yokosumei/Keryke-OS/kerike_concurs/docs/schema de conectare raspberry pi.drawio.png

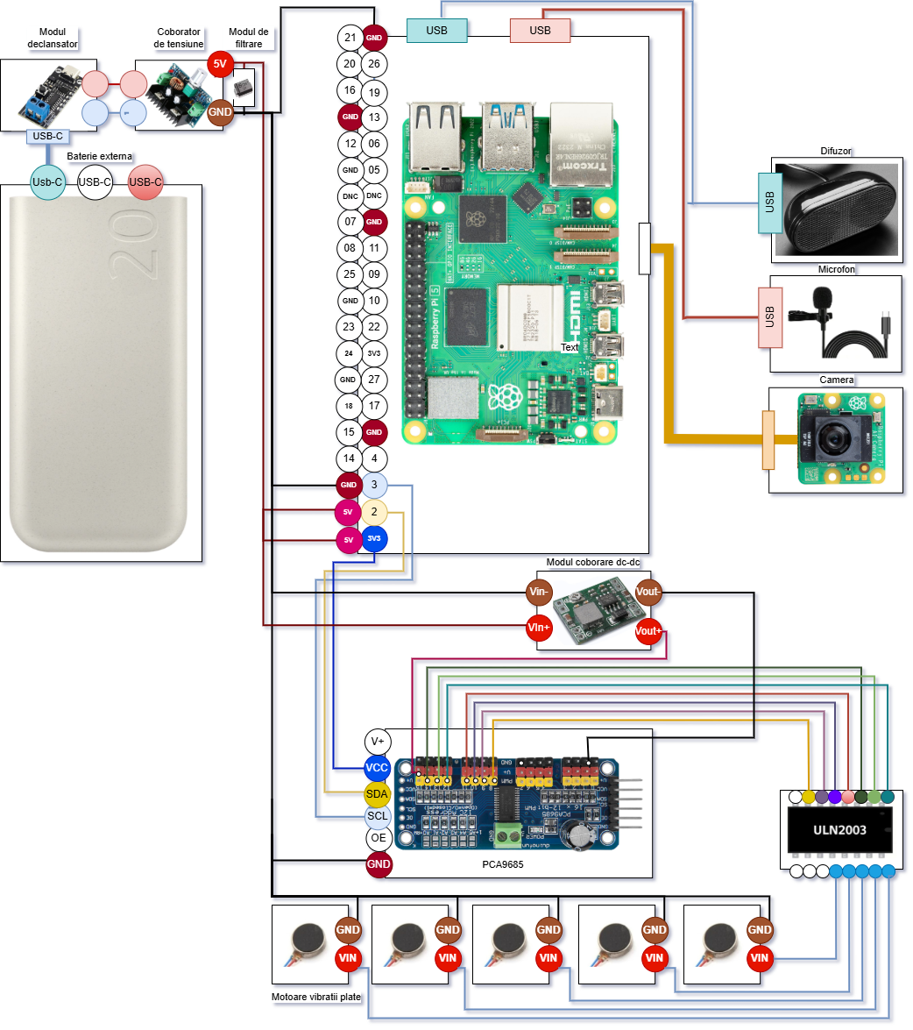
kerike_concurs/docs/schema de conectare raspberry pi.drawio.png
