yokosumei/Keryke-OS/kerike_concurs/docs/fig4_heartbeat.png

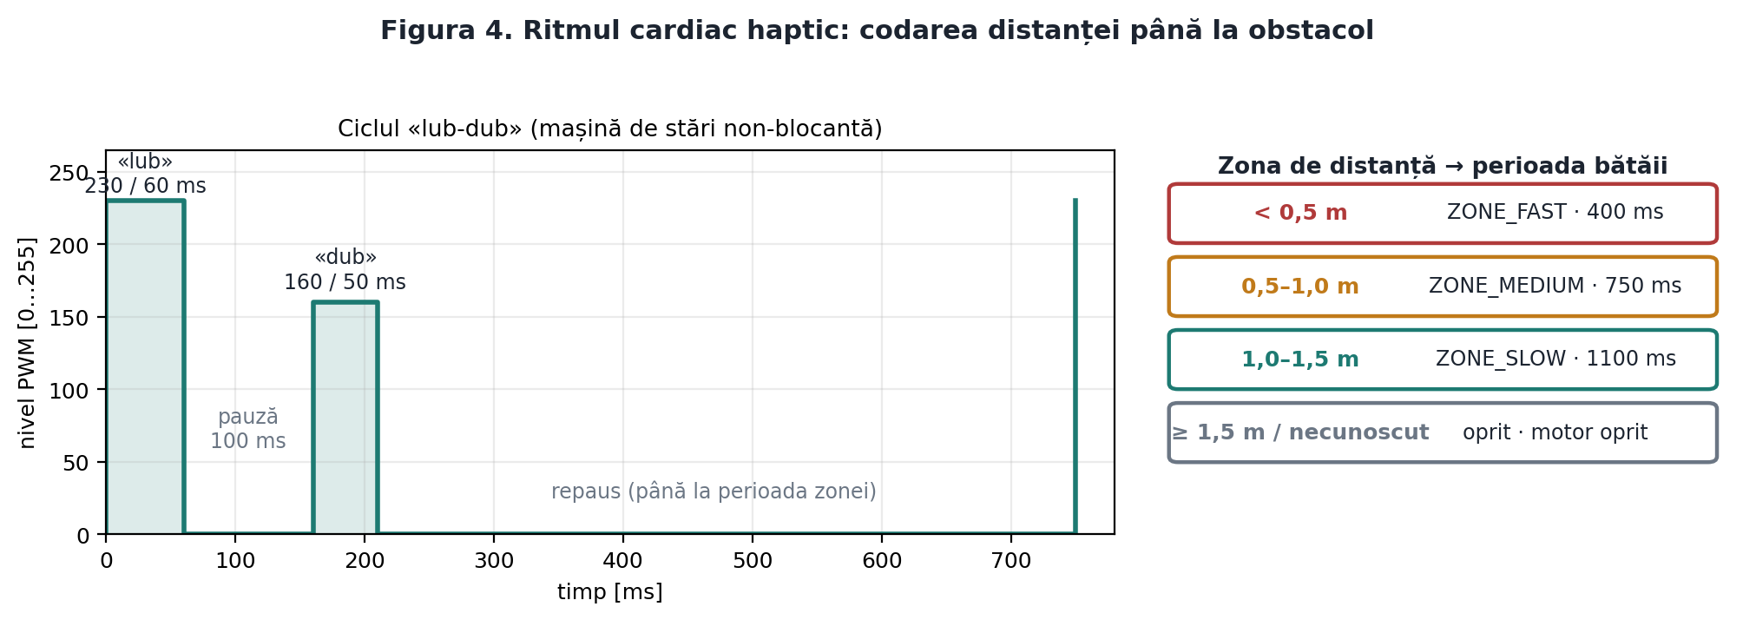
kerike_concurs/docs/fig4_heartbeat.png
