yokosumei/Keryke-OS/kerike_concurs/docs/fig5_schema_orcad_baston.png

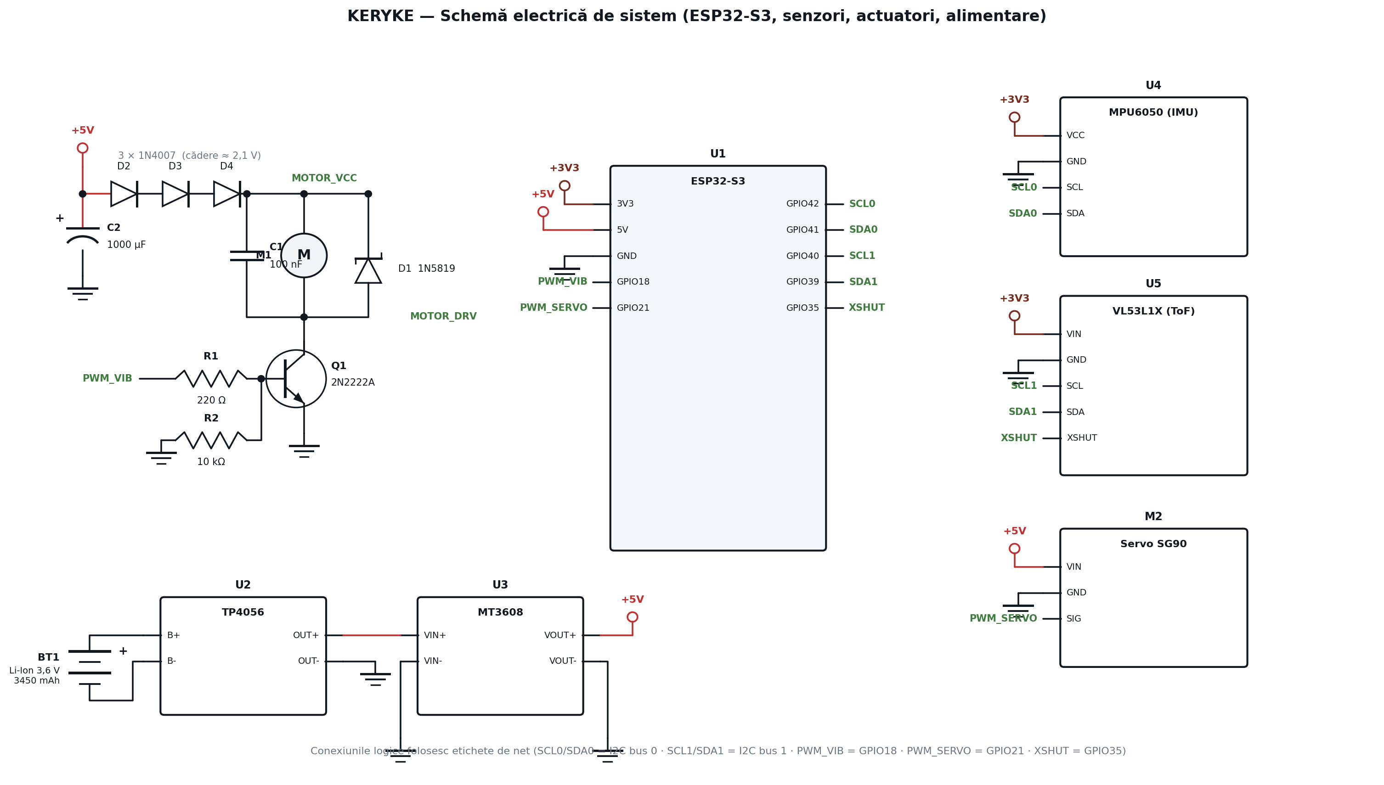
kerike_concurs/docs/fig5_schema_orcad_baston.png
