yokosumei/Keryke-OS/kerike_concurs/docs/fig9_schema_Orcad_raspberryPi.png

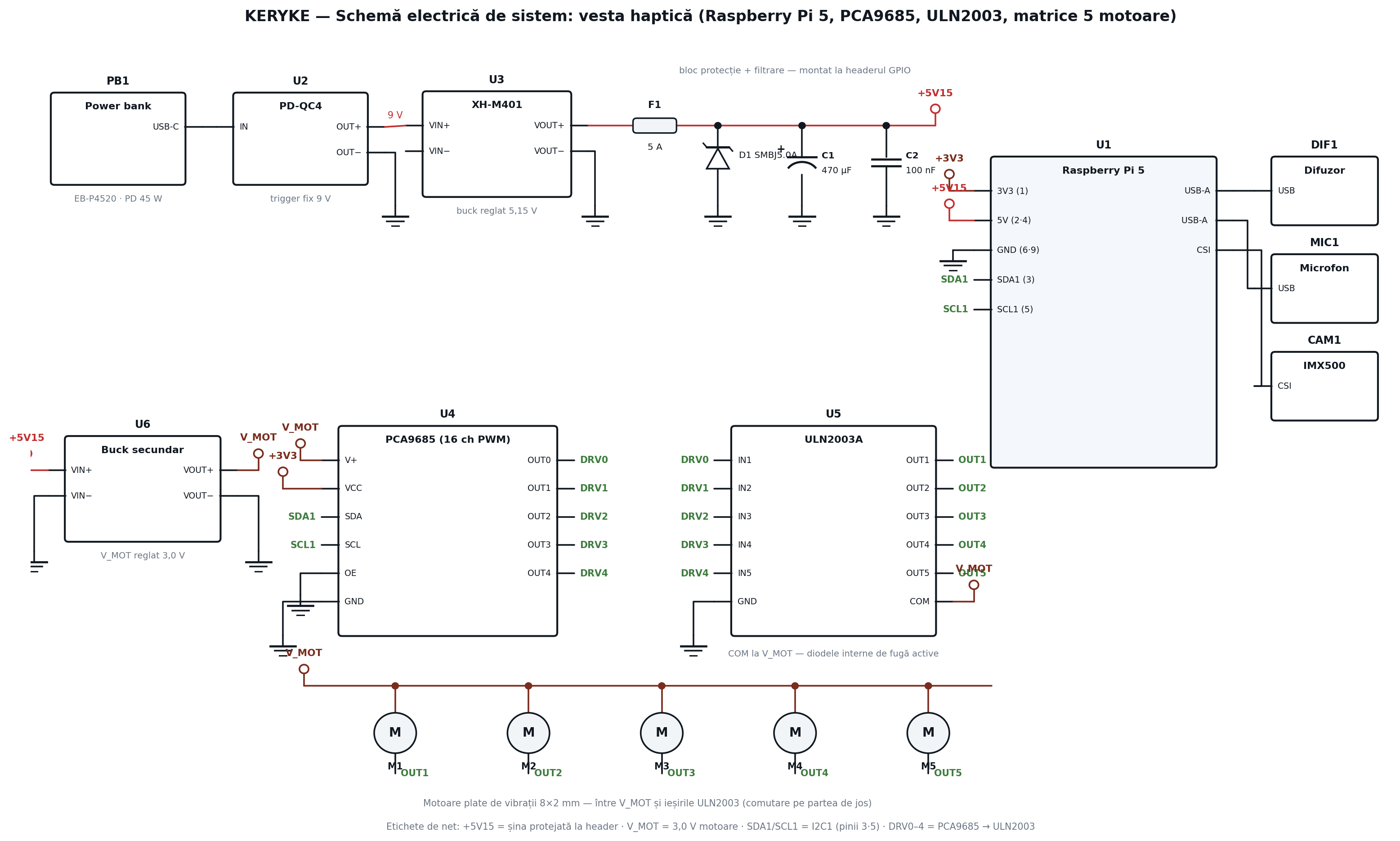
kerike_concurs/docs/fig9_schema_Orcad_raspberryPi.png
